CristianSLazar/OpenBook/Images/Device/back_view.png

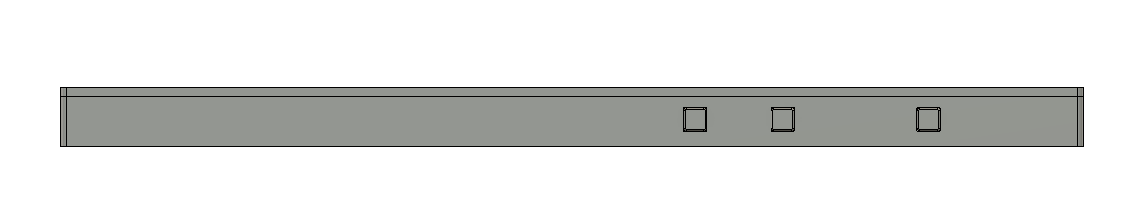
Images/Device/back_view.png
