CristianSLazar/OpenBook/Images/Device/bottom_view.png

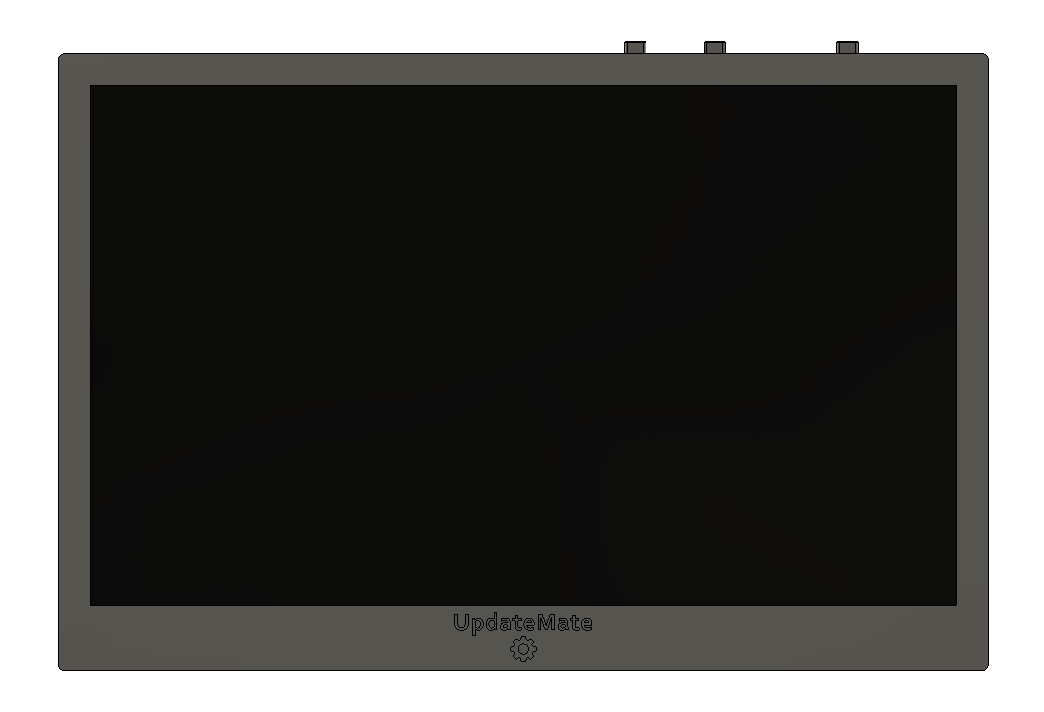
Images/Device/bottom_view.png
