CristianSLazar/OpenBook/Images/Device/left_view.png

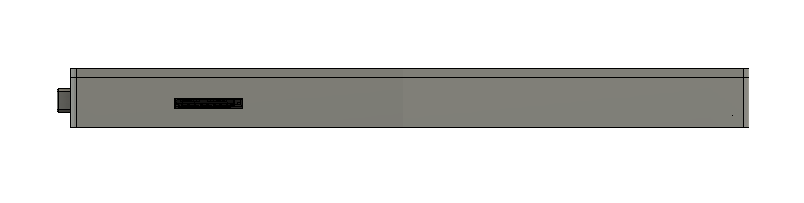
Images/Device/left_view.png
