CristianSLazar/OpenBook/Images/Device/perspective_view_1.png

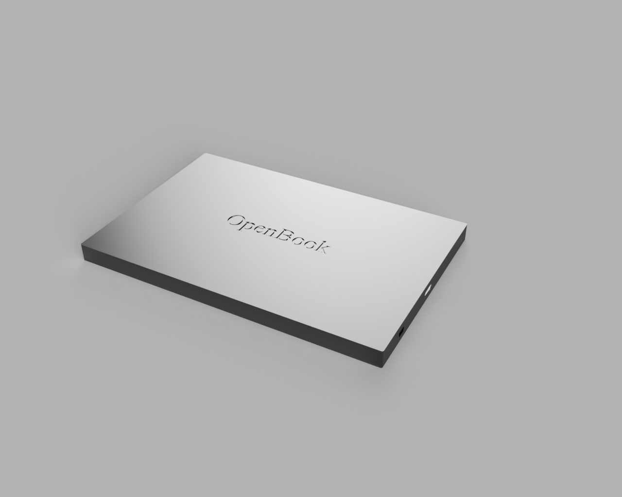
Images/Device/perspective_view_1.png
