CristianSLazar/OpenBook/Images/Device/perspective_view_2.png

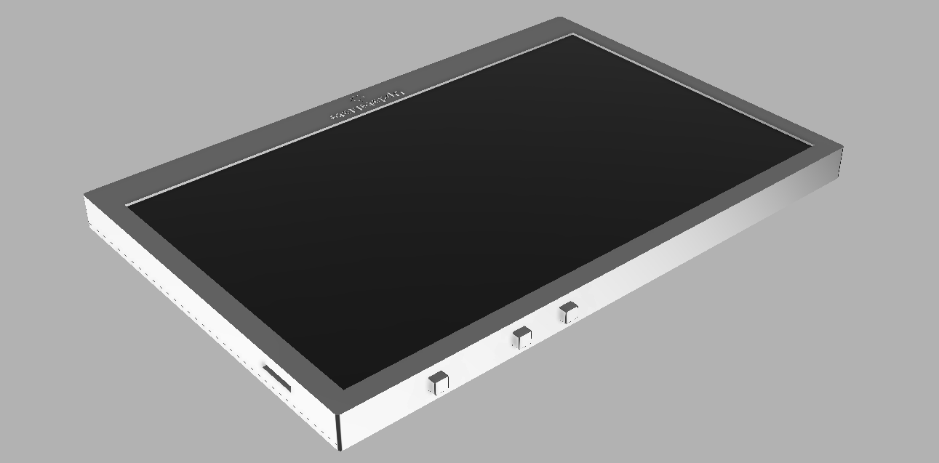
Images/Device/perspective_view_2.png
