CristianSLazar/OpenBook/Images/Device/right_view.png

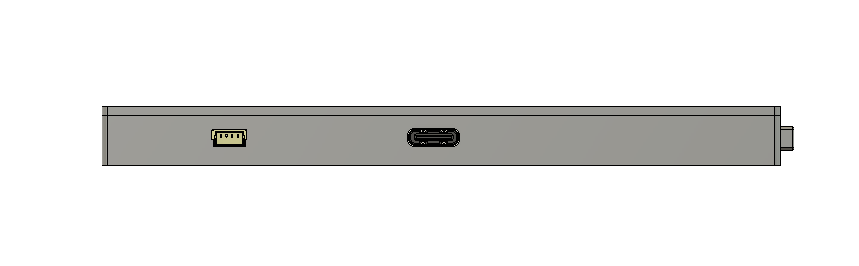
Images/Device/right_view.png
