CristianSLazar/OpenBook/Images/Device/top_view.png

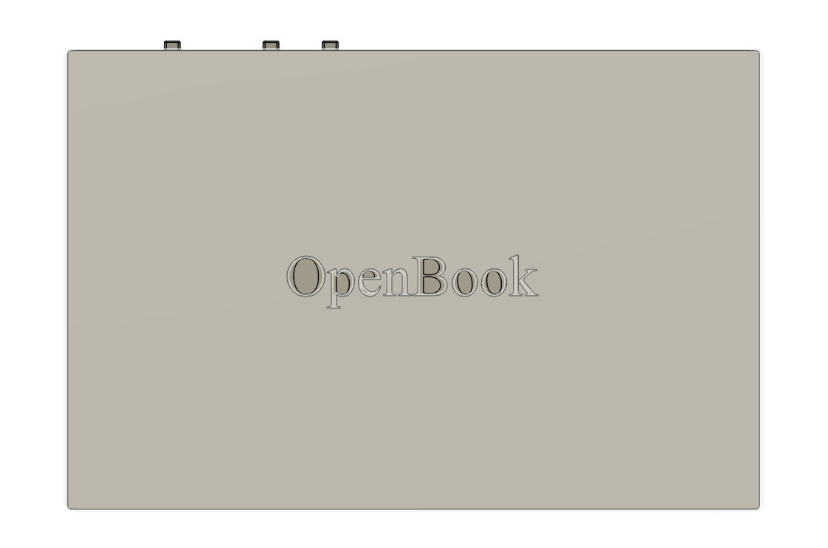
Images/Device/top_view.png
