CristianSLazar/OpenBook/Images/PCB/bottom_view.png

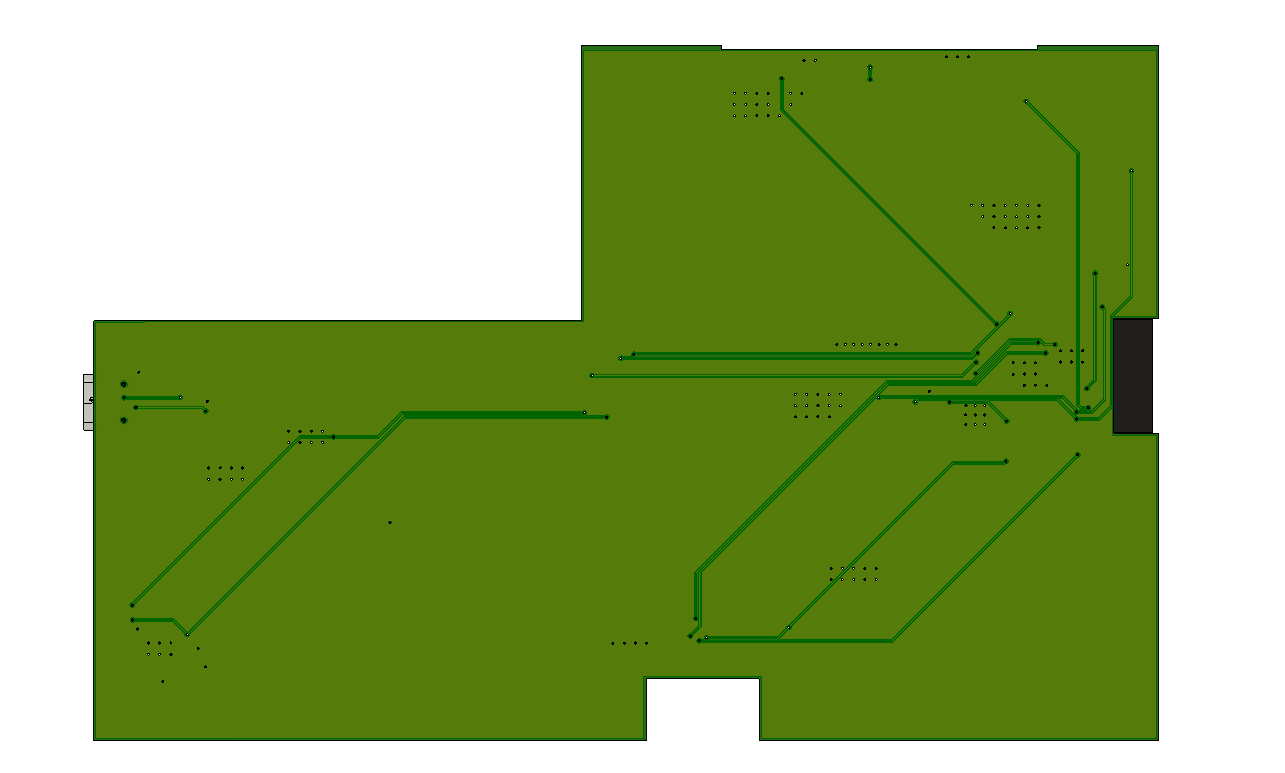
Images/PCB/bottom_view.png
