CristianSLazar/OpenBook/Images/PCB/perspective_view_1.png

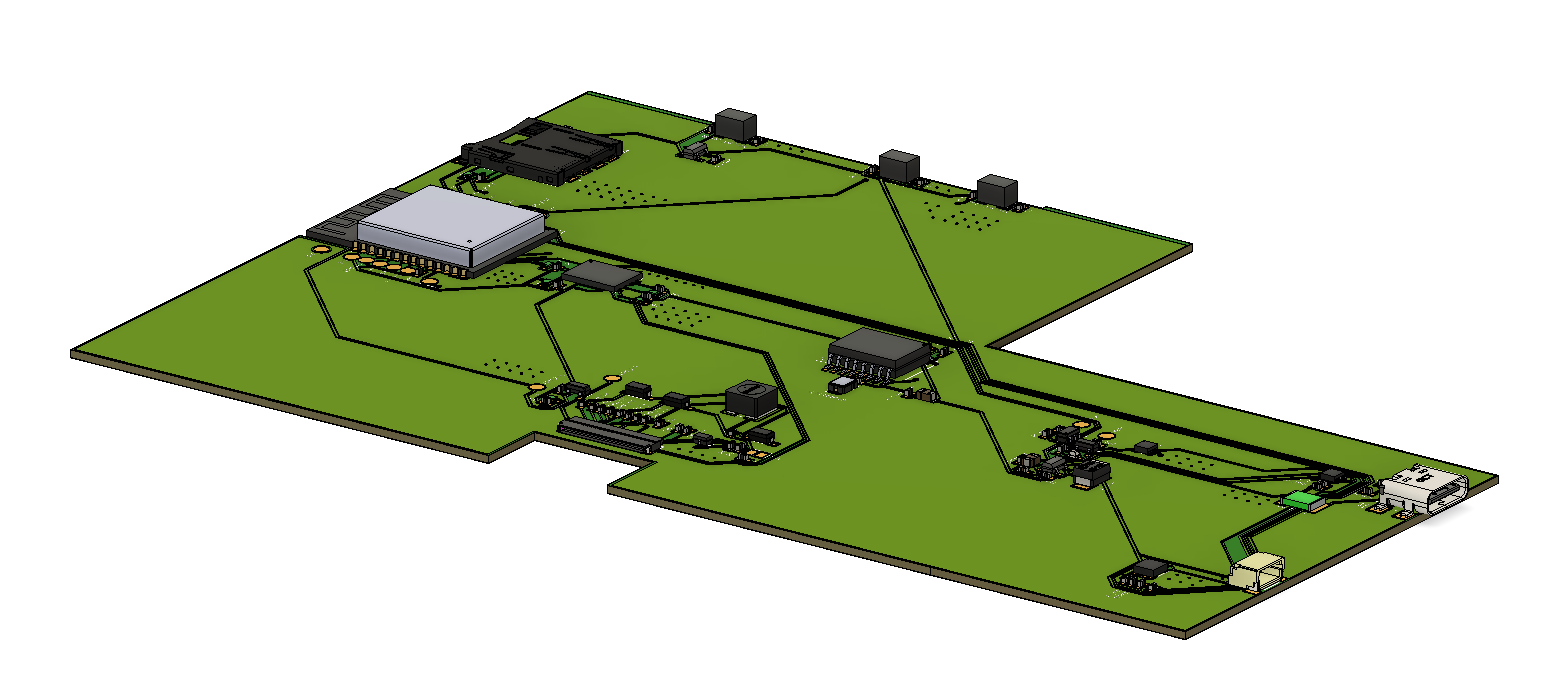
Images/PCB/perspective_view_1.png
