CristianSLazar/OpenBook/Images/PCB/perspective_view_2.png

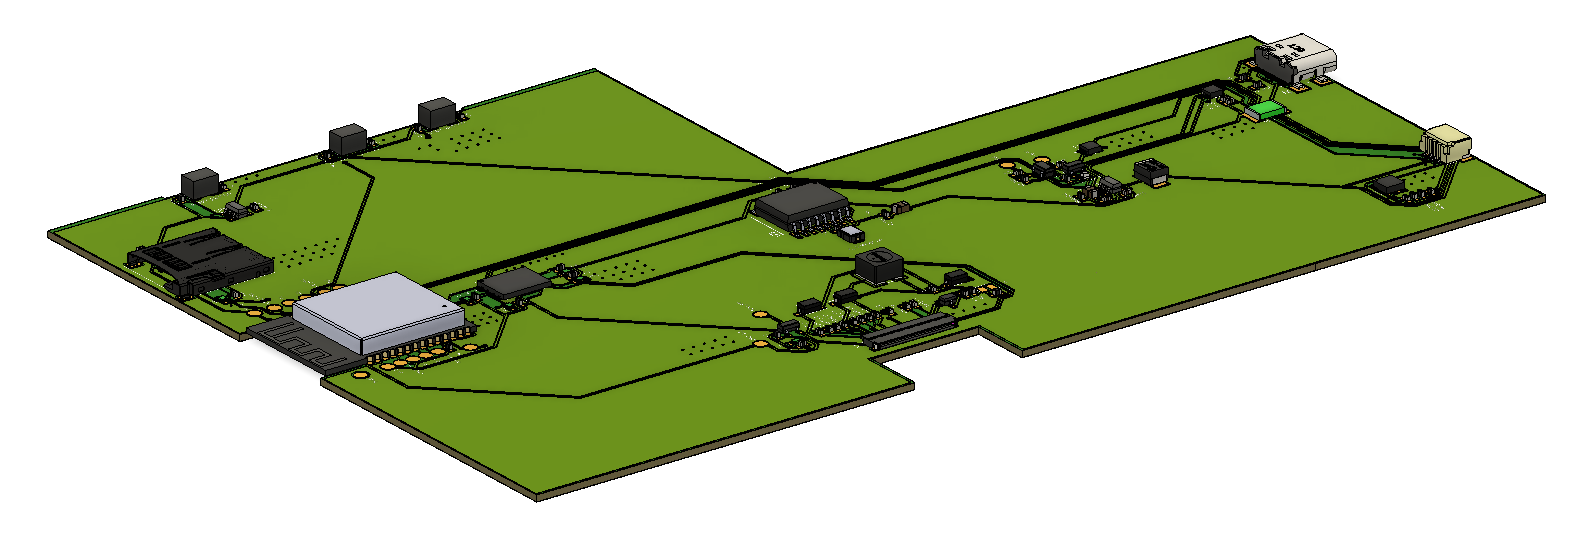
Images/PCB/perspective_view_2.png
