CristianSLazar/OpenBook/Images/PCB/top_view.png

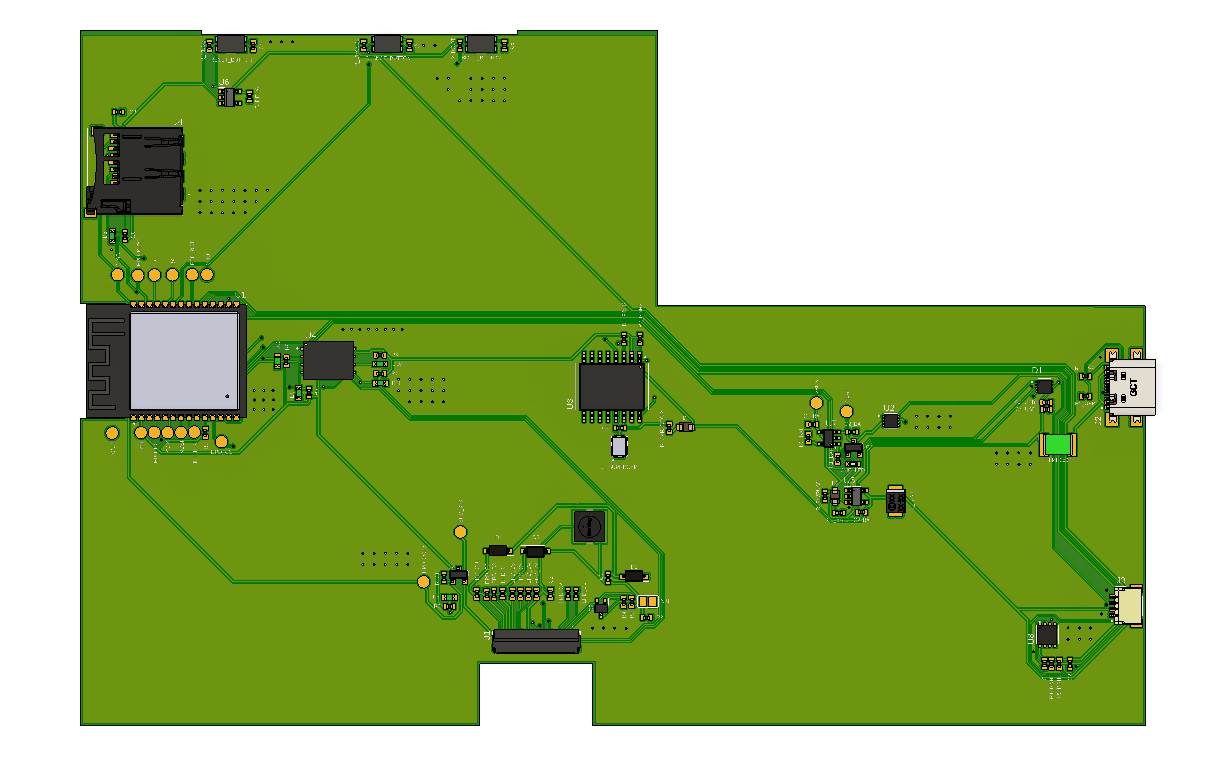
Images/PCB/top_view.png
