CristianSLazar/OpenBook/(threads)

Thread 1 (2025-04-10):

Schematic issues

DrescoAV, 2025-04-10:

Closed 2025-04-12.

Thread 2 (2025-04-10):

Lipsa frame

DrescoAV, 2025-04-10:
Cand am deschis schematicul am observat ca iti lipseste frame-ul. Se numeste ESP32_WROVER_FRAMES_A3L-LOC.

Closed 2025-04-12.

Thread 4 (2025-04-10):

Piese denumite gresit

DrescoAV, 2025-04-10:
Am observat ca ai denumit gresit anumite rezistente si condensatoare. Iti sugerez sa iei la rand fiecare componenta de [aici](https://ocw.cs.pub.ro/courses/_media/tsc/deskassistant_v15.pdf) si sa verifici.
De exemplu, la "USB C connector & ESD protection" sunt gresit numite rezistentele conectate la pinurile A5 SI B5. De asemenea valoarea lui J2 nu ar trebui sa apara.

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

CristianSLazar, 2025-04-11:
Mi-am asumat libertatea să asignez eu reference designators, conform convențiilor IEEE.

CristianSLazar, 2025-04-12:
Similar, am decis să afișez in schematic numele mai multor componente.

Closed 2025-04-12.

Thread 5 (2025-04-10):

Board Issues

DrescoAV, 2025-04-10:
Issues to fix on board

CristianSLazar, 2025-04-12:
All sub-issues resolved

Closed 2025-04-12.

Thread 8 (2025-04-10):

Silkscreen

DrescoAV, 2025-04-10:
Unele nume de pe silkscreen nu se vad bine sau deloc. De exmplu:

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

sau

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

CristianSLazar, 2025-04-11:
Descrierile de pe silkscreen le observ plasate corect cand deschid eu modelul PCB-ului. Da un git pull pe local si verifica dinnou.

DrescoAV, 2025-04-11:
A fost greseala mea, este corect la tine. Issue closed.

Closed 2025-04-11.

Thread 10 (2025-04-11):

Exploded view wrong

DrescoAV, 2025-04-11:
Am vazut ca nu ai fișierul 3D cu dispozitivul complet (PCB + baterie + display + carcasa) - exploded view (.step). Tu ai totul enclosed.

Closed 2025-04-14.
