CristianSLazar/OpenBook/(commit log)

2025-03-24 Added schematic
    [OpenBook_v3.sch]
2025-04-06 Added the project.
    [OpenBook.brd, OpenBook.sch]
2025-04-12 Fixes #2, fixes #3; Adds the frame and module names in the schematic
    [OpenBook.sch]
2025-04-12 Fixes #6, fixes #7, fixes #9
    [OpenBook.brd]
2025-04-12 Modified PCB dielectric layer thickness
2025-04-14 Fixes #10; Fixes overlaps and misdimensions in 3d model and changes format of board and schematic files
    [OpenBook.sch]
2025-04-14 Update README.md
    Fixes #11; Adds missing components to README bill of materials
2025-04-15 Renames schematic
2025-04-15 Moves schematic separation lines to Info layer
